dakota127/Triangle/Docu/Pictures/tria-10.jpg

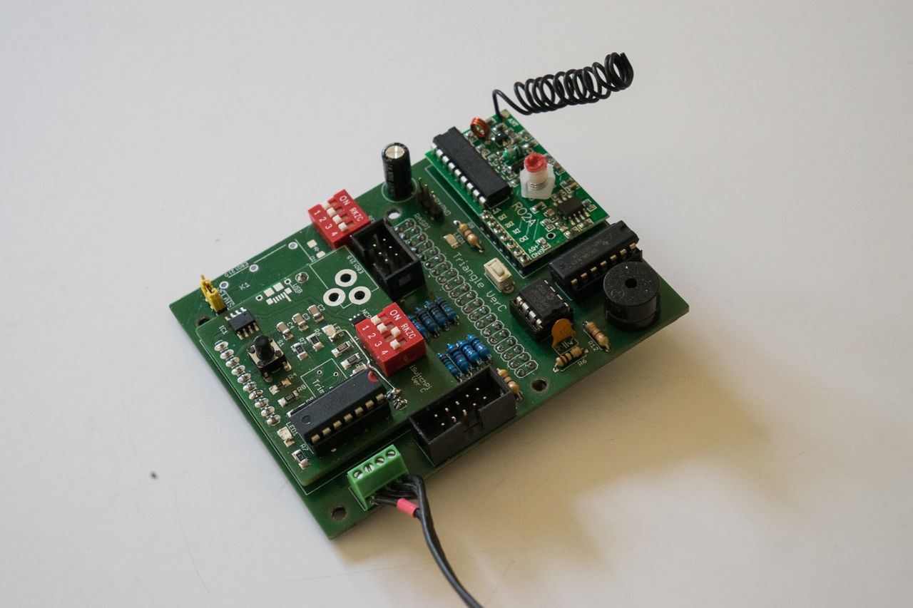
Docu/Pictures/tria-10.jpg
