dakota127/Triangle/Docu/Pictures/tria-9.jpg

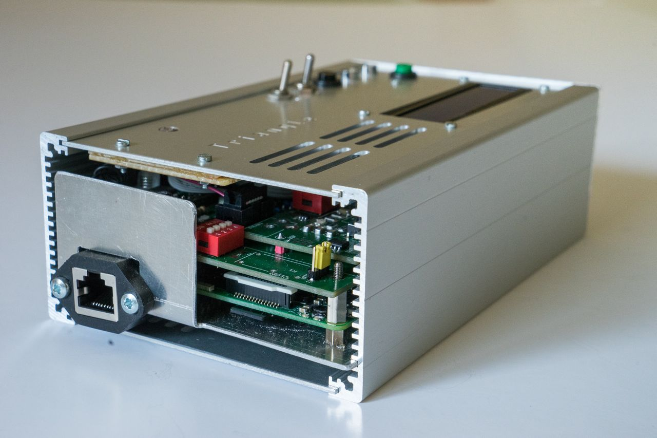
Docu/Pictures/tria-9.jpg
