dakota127/Triangle/Docu/Pictures/tria-1.jpg

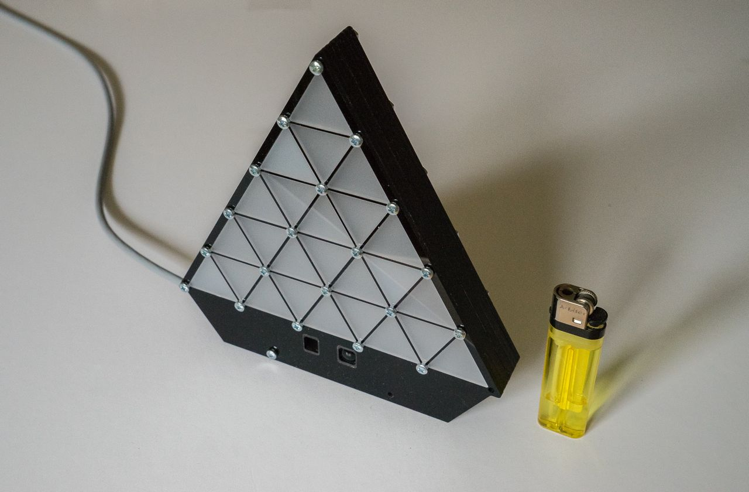
Docu/Pictures/tria-1.jpg
