dakota127/Triangle/Docu/Pictures/tria-2.jpg

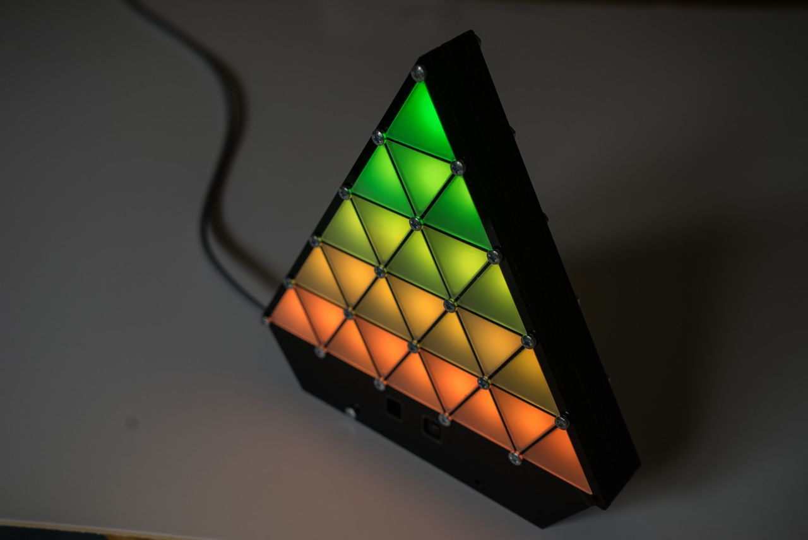
Docu/Pictures/tria-2.jpg
