dakota127/Triangle/Docu/Pictures/tria-3.jpg

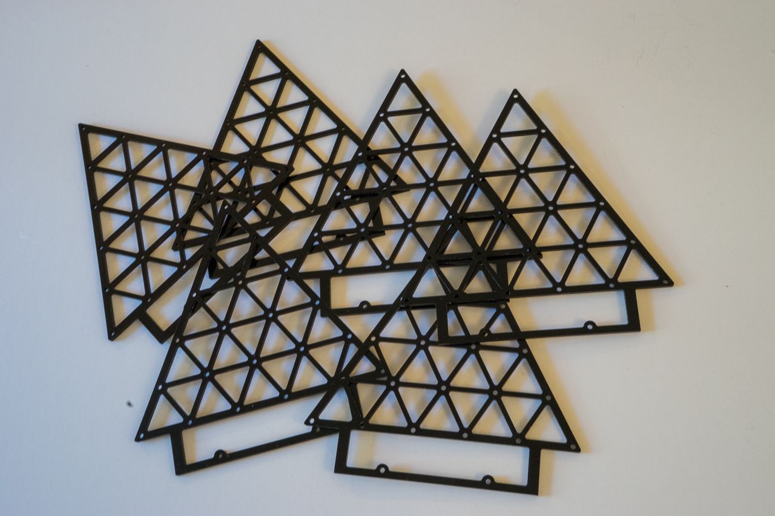
Docu/Pictures/tria-3.jpg
