dakota127/Triangle/Docu/Pictures/tria-4.jpg

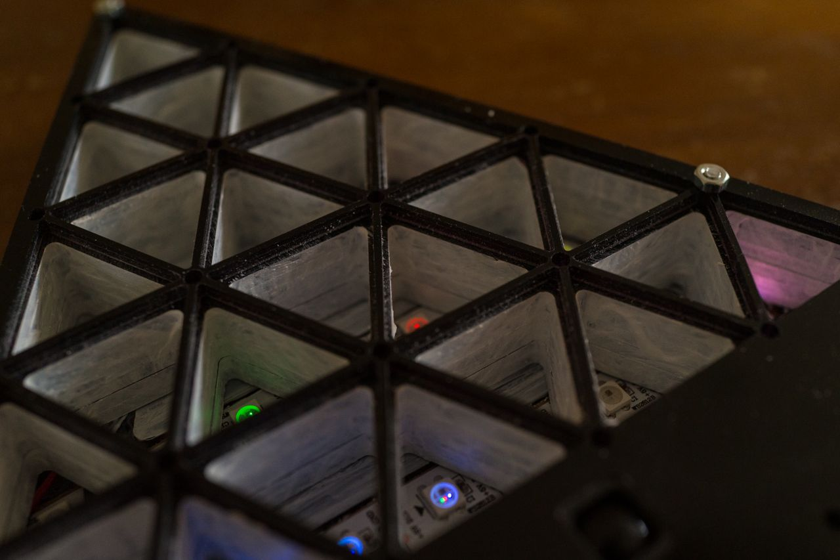
Docu/Pictures/tria-4.jpg
