dakota127/Triangle/Docu/Pictures/tria-5.jpg

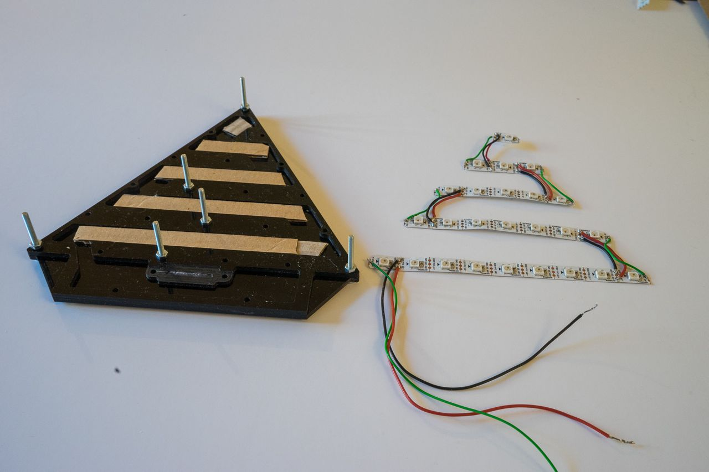
Docu/Pictures/tria-5.jpg
