dakota127/Triangle/Docu/Pictures/tria-6.jpg

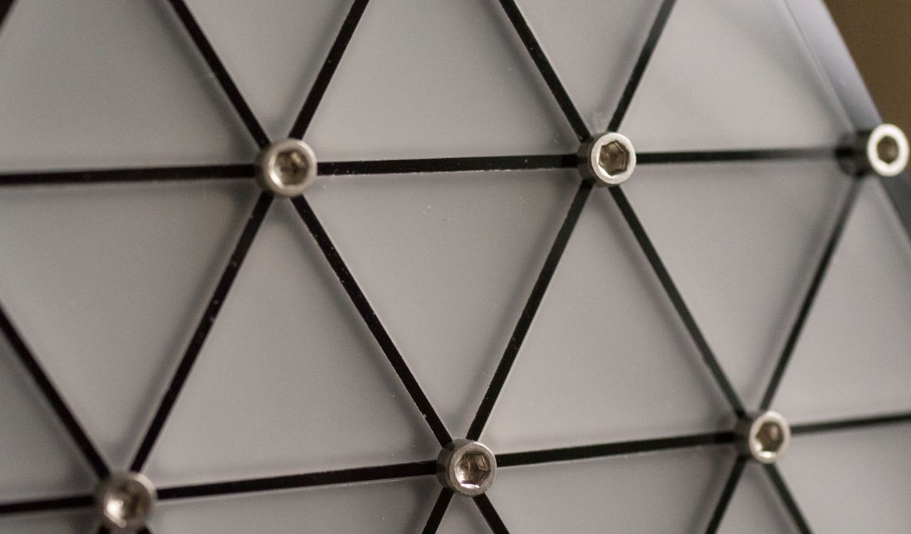
Docu/Pictures/tria-6.jpg
