dakota127/Triangle/Docu/Pictures/tria-7.jpg

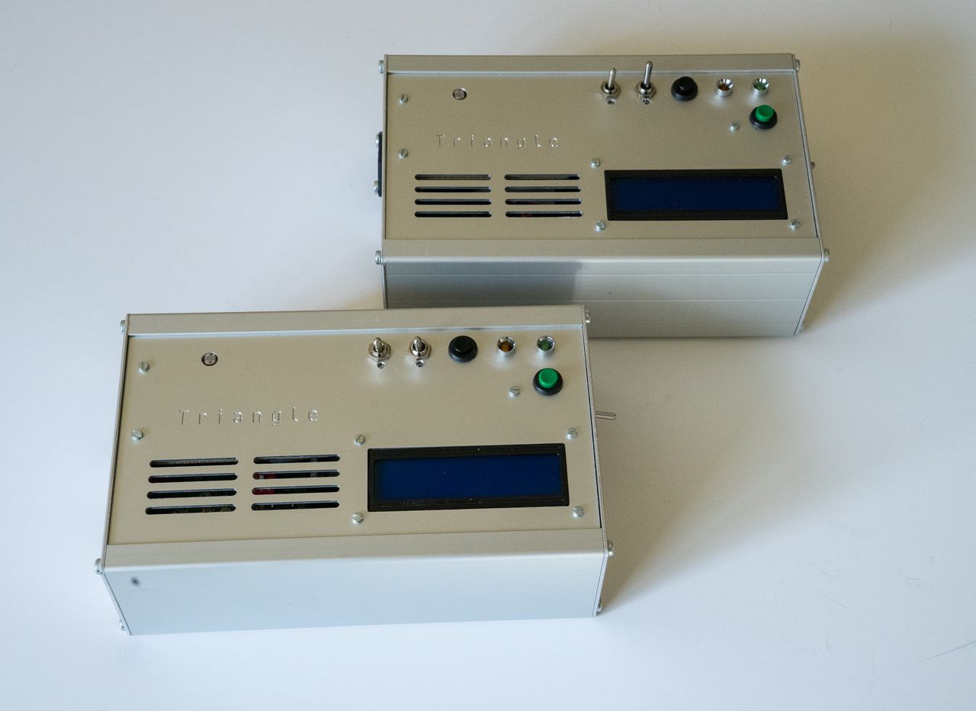
Docu/Pictures/tria-7.jpg
