dakota127/Triangle/Docu/Pictures/tria-8.jpg

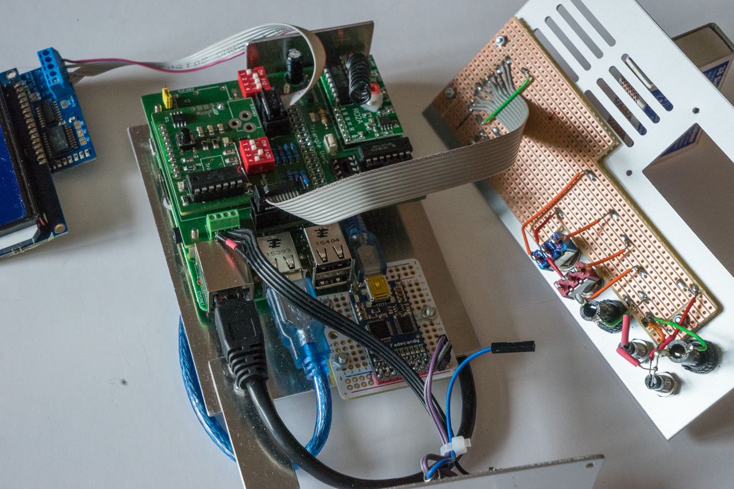
Docu/Pictures/tria-8.jpg
