dakota127/Triangle/Sources/processing-scripts/triangle25_attractor/data/colors00.png

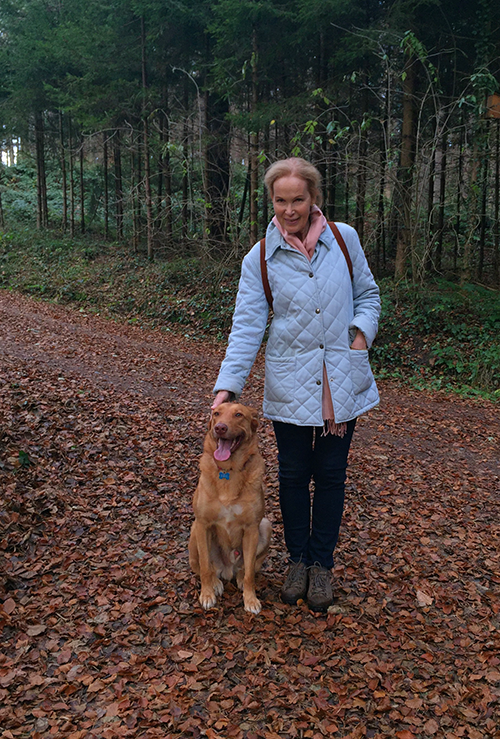
Sources/processing-scripts/triangle25_attractor/data/colors00.png
