dakota127/Triangle/Sources/processing-scripts/triangle25_attractor/data/colors04.png

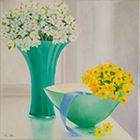
Sources/processing-scripts/triangle25_attractor/data/colors04.png
