dakota127/Triangle/Sources/processing-scripts/triangle25_attractor/data/colors07.png

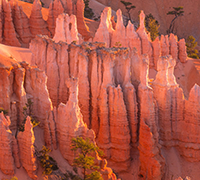
Sources/processing-scripts/triangle25_attractor/data/colors07.png
