dakota127/Triangle/Sources/processing-scripts/triangle25_attractor/data/colors08.png

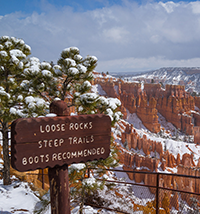
Sources/processing-scripts/triangle25_attractor/data/colors08.png
