dakota127/Triangle/Sources/processing-scripts/triangle25_attractor/data/colors09.png

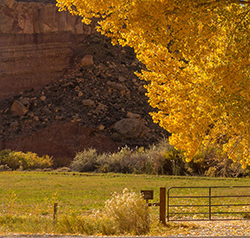
Sources/processing-scripts/triangle25_attractor/data/colors09.png
