dakota127/Triangle/Sources/processing-scripts/triangle25_wavefronts/triangle25_wavefronts.pde

class Ring
{
  float x, y, size, intensity, hue;

  void respawn(float x1, float y1, float x2, float y2)
  {
    // Start at the newer mouse position
    x = x2;
    y = y2;
    
    // Intensity is just the distance between mouse points
    intensity = dist(x1, y1, x2, y2);
    
    // Hue is the angle of mouse movement, scaled from -PI..PI to 0..100
    hue = map(atan2(y2 - y1, x2 - x1), -PI, PI, 0, 100);

  // Default size is based on the screen size
    size = height * 0.1;
  }

  void draw()
  {
    // Particles fade each frame
    intensity *= 0.95;
    
    // They grow at a rate based on their intensity
    size += height * intensity * 0.01;

    // If the particle is still alive, draw it
    if (intensity >= 1) {
      blendMode(ADD);
      tint(hue, 50, intensity);
      image(texture, x - size/2, y - size/2, size, size);
    }
  }
};

OPC opc;
PImage texture;
Ring rings[];
TriangleGrid triangle;
float smoothX, smoothY;
boolean f = false;

void setup()
{
  size(500, 400, P3D);
  colorMode(HSB, 100);
  texture = loadImage("ring.png");

  opc = new OPC(this, "127.0.0.1", 7890);

  // Map our triangle grid to the center of the window
  triangle = new TriangleGrid();
  triangle.grid25();
  triangle.printcells(1);
  triangle.mirrorv();              // trinagle upside down, ist nachher nach unten
    triangle.printcells(2);
  triangle.scale(height * 0.21);    // umsetzen in Fensterhöhe, x ist null
    triangle.printcells(3);
  triangle.translate(width * 0.37, height * 0.7);   // umsetzten in fentergrösse
    triangle.printcells(4);
  triangle.leds(opc, 0);

  // We can have up to 100 rings. They all start out invisible.
  rings = new Ring[100];
  for (int i = 0; i < rings.length; i++) {
    rings[i] = new Ring();
  }
}

void draw()
{
  background(0);

  // Smooth out the mouse location. The smoothX and smoothY variables
  // move toward the mouse without changing abruptly.
  float prevX = smoothX;
  float prevY = smoothY;
  smoothX += (mouseX - smoothX) * 0.1;
  smoothY += (mouseY - smoothY) * 0.1;

  // At every frame, randomly respawn one ring
  rings[int(random(rings.length))].respawn(prevX, prevY, smoothX, smoothY);

  // Give each ring a chance to redraw and update
  for (int i = 0; i < rings.length; i++) {
    rings[i].draw();
  }
}
